undefined-0/2023NUEDC/bsp/oledfont.h

#ifndef _OLEDFONT_H_
#define _OLEDFONT_H_

extern const unsigned char F6x8[][6];
extern const unsigned char F8X16[];
extern const unsigned char Hzk[][32];
extern unsigned char BMP1[];
//extern unsigned char BMP2[].........
#endif /* _OLEDFONT_H_ */
