undefined-0/2023NUEDC/(commit log)

2025-07-09 完成STM32F103C8T6核心板驱动I2C四线小屏幕，完成PA3、PA4口检测外部按键按下，并于串口发送当前测量内容（长度Length、负载Load），在屏幕上显示测量内容（同前）。
2025-07-09 将外部按键检测脚改为PB8、PB9，在README中新增了本题中电缆长度测量的简要思路。
2025-07-09 实现从核心板PA8输出1MHz、占空比50%的方波激励信号。
2025-07-09 实现从PA0-PA7这八个io读取并处理数据，并将数据的2进制序列与10进制结果同时从usart1阻塞式输出。
2025-07-09 实现OLED实时以10进制形式展示PA0-PA7所读数据（通过：<将length_x转为uint8_t字符串类型后存入uint8_t字符数组，再传给需要uint8_t*类型参数的oled显示函数> 实现）
2025-07-09 将PA8输出的激励信号由1MHz改为200kHz。实现采用ADC1扫描模式读取PB0、PB1两个IO口的外部电压，并通过串口输出值。
2025-07-10 实现将PB0口改为<对激励方波进行采样后只取高电平的部分（电压大于某个门限）（代码中取2048）做平均>。成功从串口输出高电平部分的均值及采样点个数。
2025-07-10 实现PB0、PB1两路ADC通道皆采样方波的高电平并计算均值，实现两路均值分别从串口输出。
2025-07-10 实现对A、B点方波的高电平采样及平均采样值计算，实现从串口输出当前负载电阻值。
2025-07-10 开始正式程序的编写，成功实现求IO口输入数据的平均值并得出真实电缆长度，成功在OLED屏幕上显示带有两位小数的真实电缆长度结果。
2025-07-11 开始正式程序的编写，成功实现按下Load按键后对负载类型（电阻or电容）的判断及各自的检测逻辑。（仅实现逻辑。判断标准、拟合参数及修正算法待完善。）
2025-07-12 在README.md中增加了以比较器输出电压为负载类型判断依据的测电阻方案及相应接线方式。
2025-07-12 将main分支push到远程。新增了feature/load-type-via-time和feature/load-type-via-voltage分支。
2025-07-14 第一个实现<电压判断负载类型>逻辑下电阻和电容的判断及值别测量的版本。长度拟合参数与电压值采样缓冲区清空逻辑待优化。多余变量待优化。
2025-07-14 做了部分注释的优化。
2025-07-16 添加Apache 2.0 许可证。
2025-07-16 完成了<电压判断负载类型>的逻辑，改进了拟合函数，初步完善了文档。
2025-07-20 在README中补充了改进后的硬件电路。
2025-07-27 在文档中添加了新方案框图及焊接实物照片。
2025-07-28 在README文档中添加了旧、新方案的仿真电路图及其分析，更改了文档的标题结构。
2025-07-31 更新了README文档中新方案的仿真结果及其分析图。
